UWCubeSat/hs2-gpr-hardware/schematic.pdf

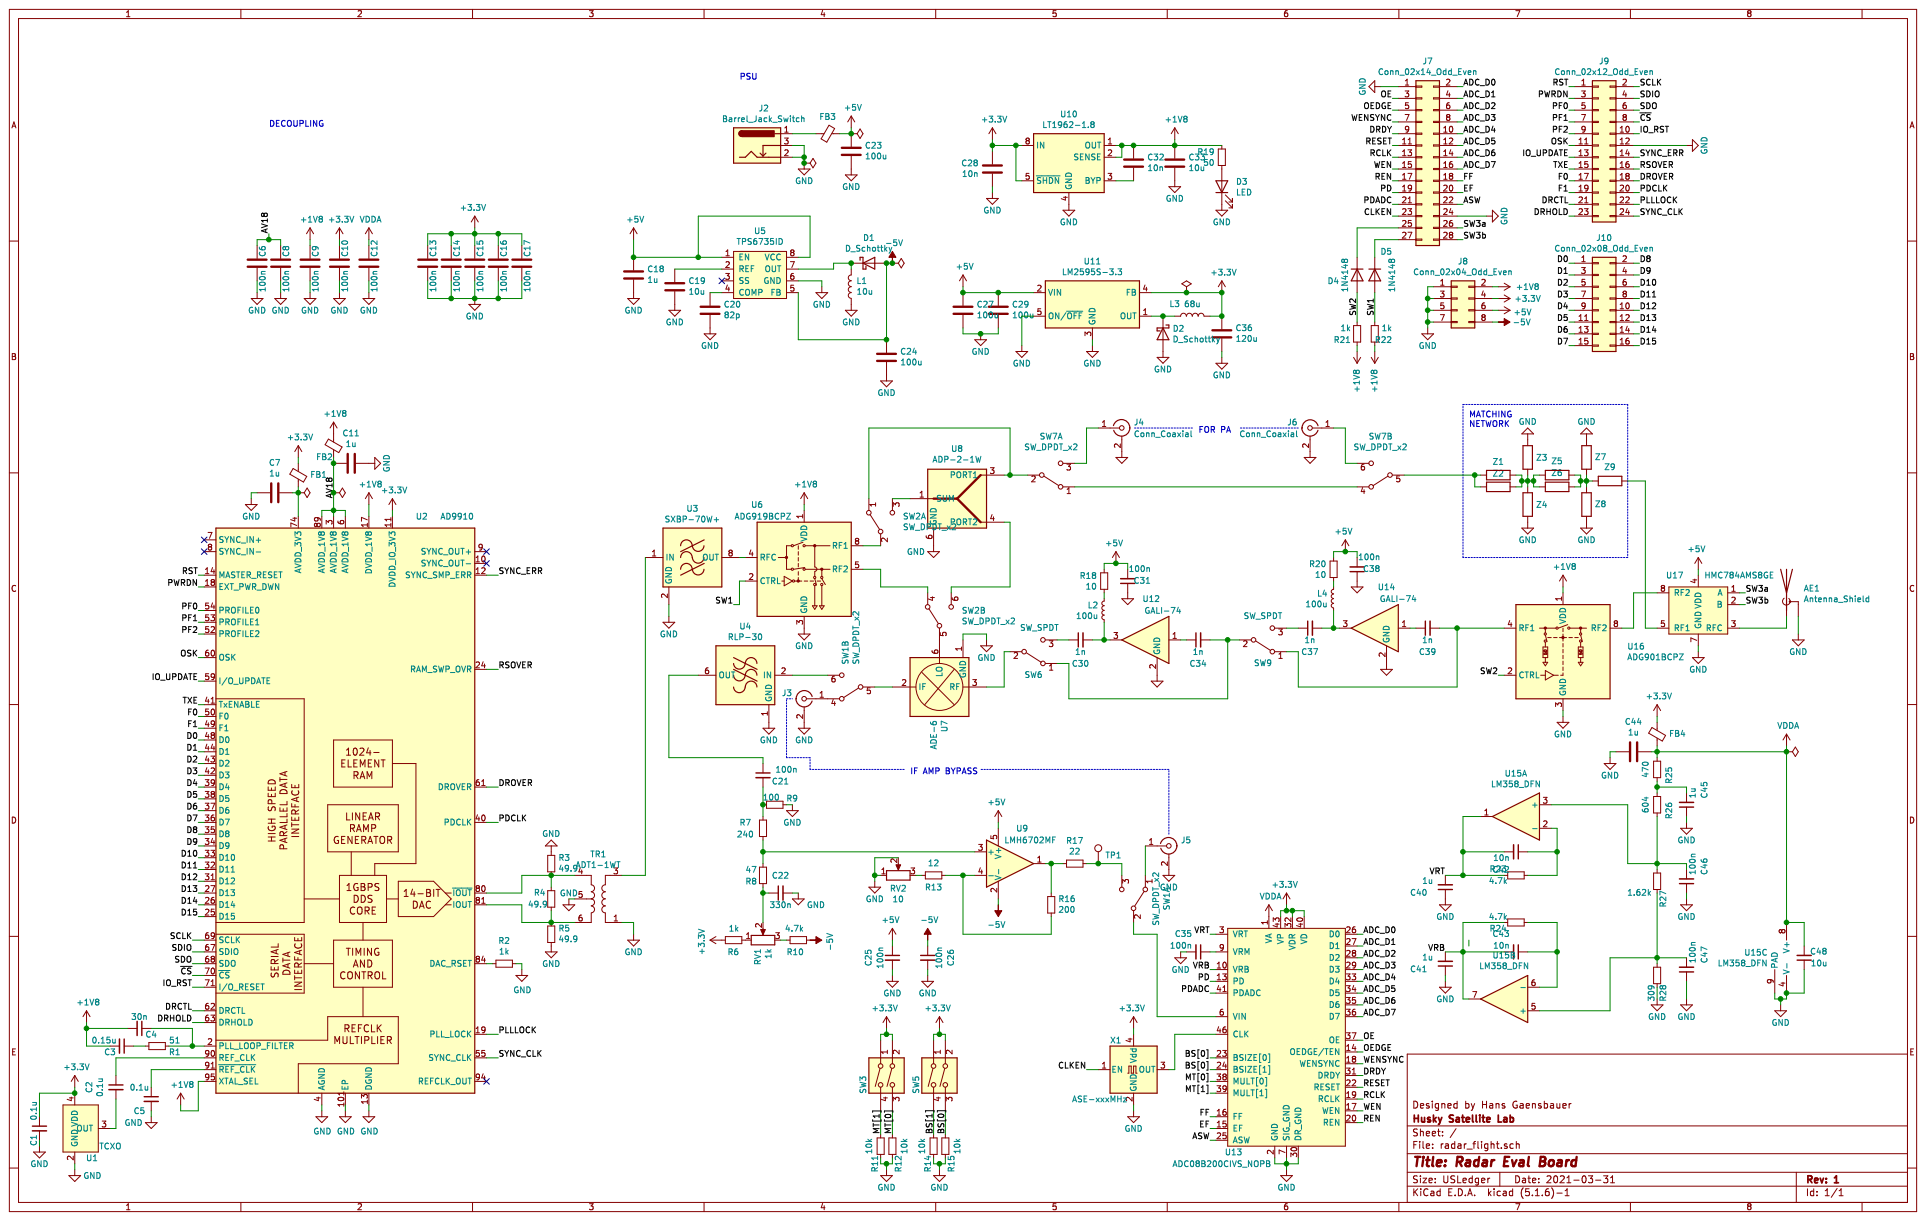
[picture p1: page 1]
