UWCubeSat/hs2-gpr-hardware/radar_flight.kicad_pcb

## KiCad design radar_flight.kicad_pcb (2021-05-08)

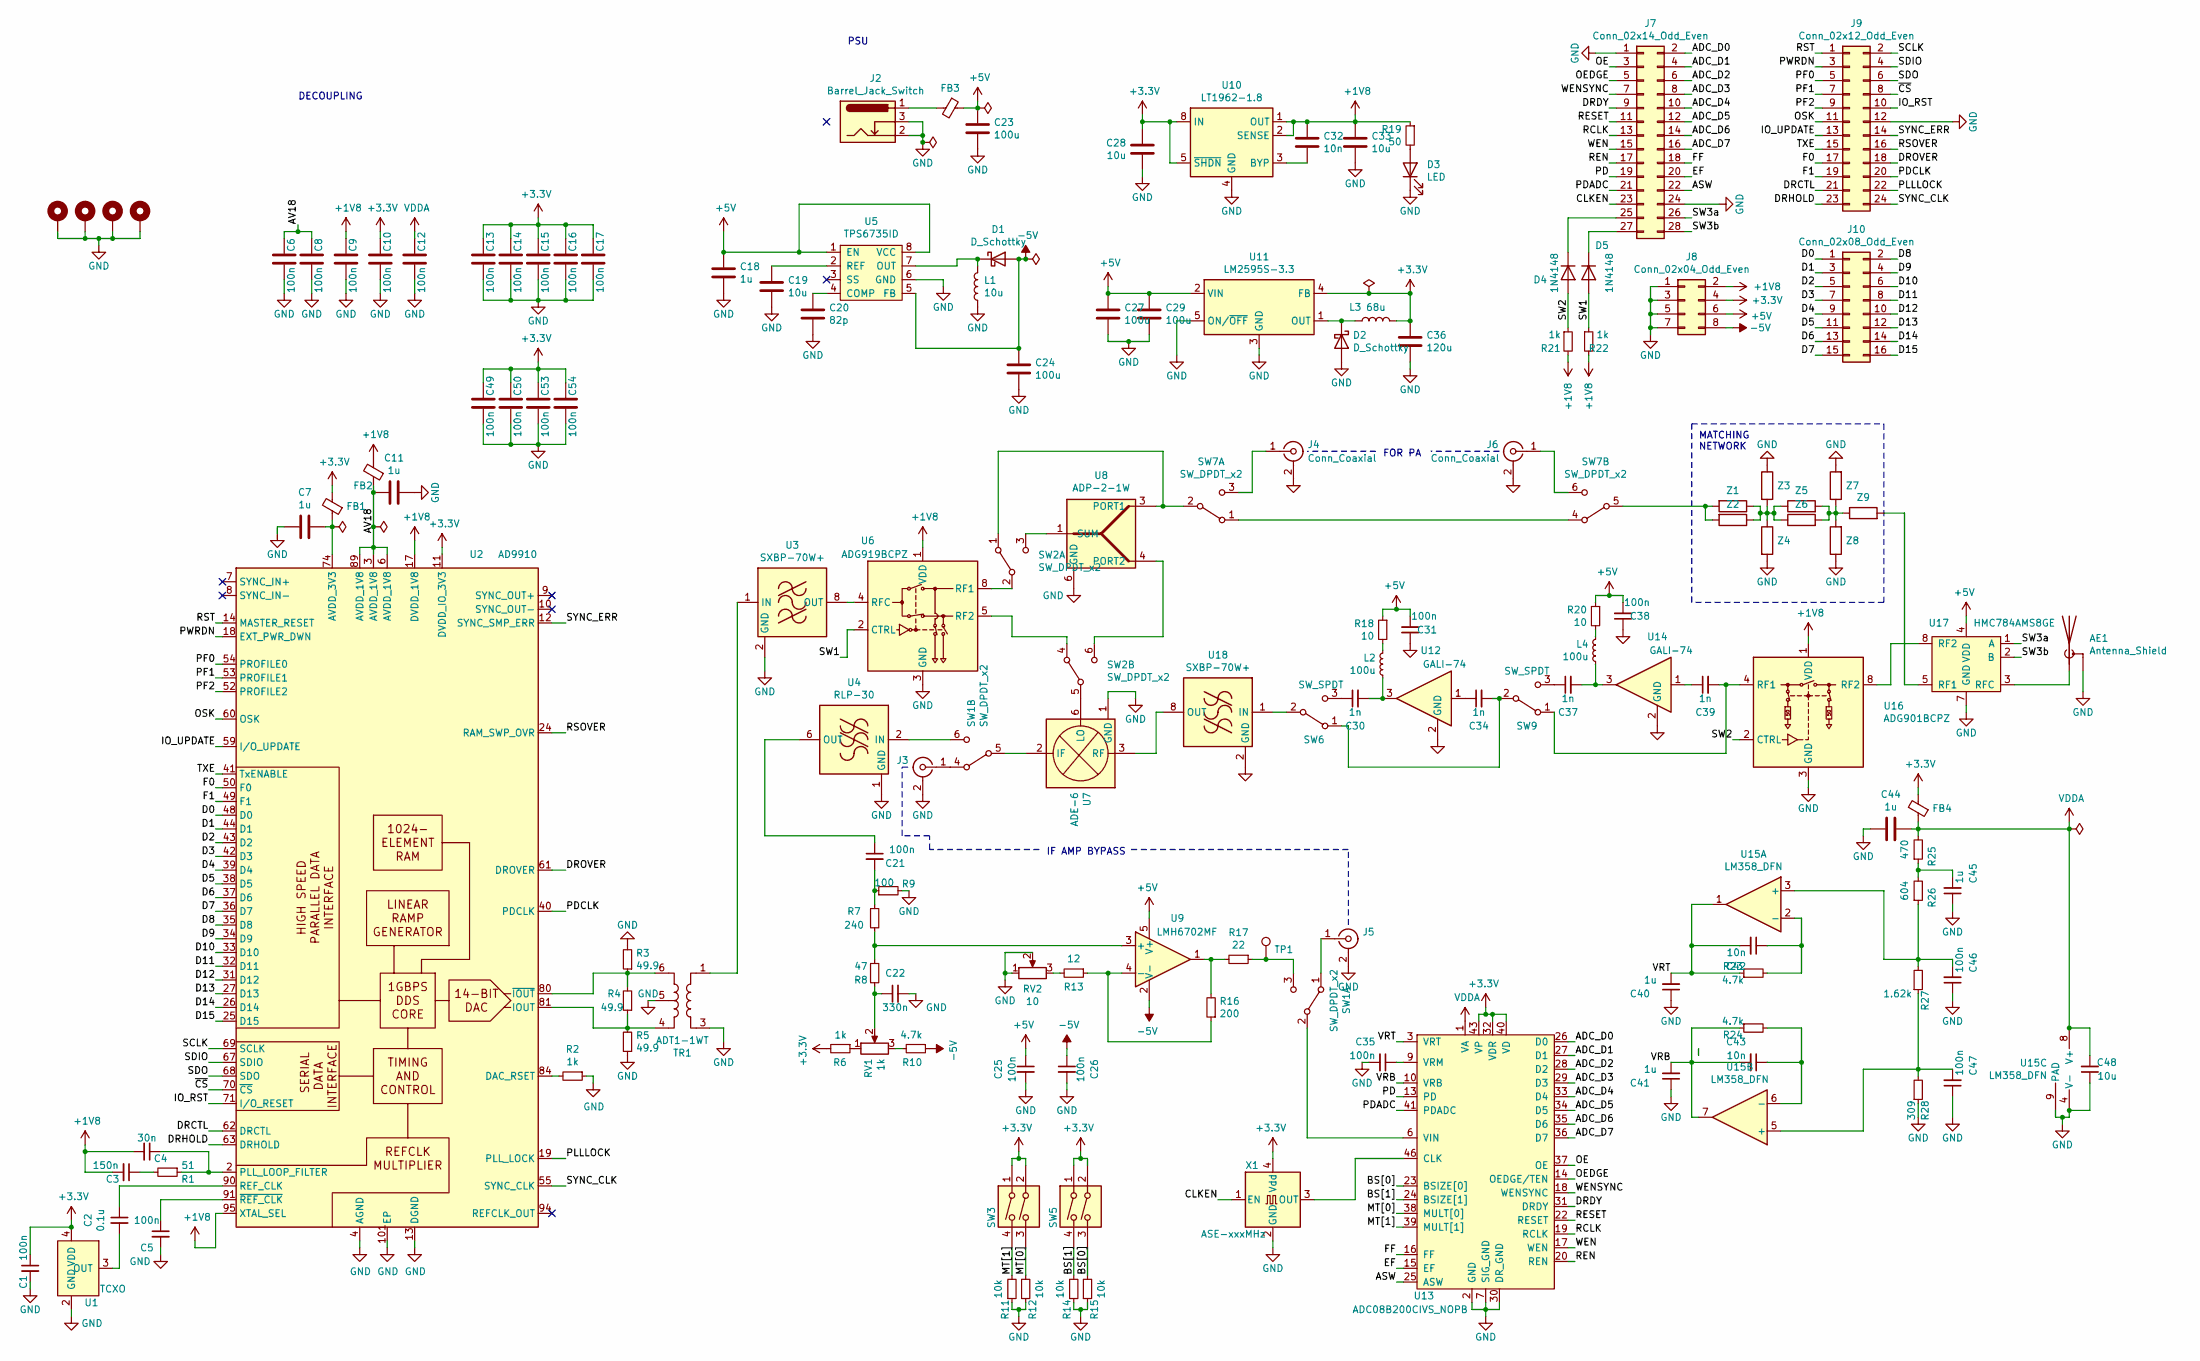
[picture p2: schematic radar_flight.sch, Radar Eval Board]

Parts:
AE1: Antenna_Shield; MMCX_Molex_73415-0961_Horizontal_0.8mm-PCB
C1, C5, C6, C8, C9, C10, C12, C13, C14, C15, C16, C17, C21, C25, C26, C31, C35, C38, C46, C47, C49, C50, C53, C54: 100n; C_0603_1608Metric
C2: 0.1u; C_0603_1608Metric
C3: 150n; C_0603_1608Metric
C4: 30n; C_0603_1608Metric
C7, C11, C18, C40, C41, C44, C45: 1u; C_0603_1608Metric
C19, C28, C33, C48: 10u; C_0603_1608Metric
C20: 82p; C_0603_1608Metric
C22: 330n; C_0603_1608Metric
C23, C24, C27, C29: 100u; C_1206_3216Metric
C30, C34, C37, C39: 1n; C_0603_1608Metric
C32, C42, C43: 10n; C_0603_1608Metric
C36: 120u; C_1206_3216Metric
D1, D2: D_Schottky; D_SMB
D3: LED; LED_0603_1608Metric
D4, D5: 1N4148; D_SOD-123
FB1, FB2, FB3, FB4: Ferrite_Bead_Small; L_0805_2012Metric
H1, H2, H3, H4: MountingHole_Pad; MountingHole_2.2mm_M2_Pad
J2: Barrel_Jack_Switch; BarrelJack_Wuerth_6941xx301002
J3, J4, J5, J6: Conn_Coaxial; SMA_Samtec_SMA-J-P-X-ST-EM1_EdgeMount
J7: Conn_02x14_Odd_Even; PinHeader_2x14_P2.54mm_Horizontal
J8: Conn_02x04_Odd_Even; PinHeader_2x04_P2.54mm_Horizontal
J9: Conn_02x12_Odd_Even; PinHeader_2x12_P2.54mm_Horizontal
J10: Conn_02x08_Odd_Even; PinHeader_2x08_P2.54mm_Horizontal
L1: 10u; L_Bourns-SRU8028_8.0x8.0mm
L2, L4: 100u; L_0805_2012Metric
L3: 68u; L_Bourns-SRU1028_10.0x10.0mm
R1: 51; R_0603_1608Metric
R2, R6, R21, R22: 1k; R_0603_1608Metric
R3, R4, R5: 49.9; R_0603_1608Metric
R7: 240; R_0603_1608Metric
R8: 47; R_0603_1608Metric
R9: 100; R_0603_1608Metric
R10, R23, R24: 4.7k; R_0603_1608Metric
R11, R12, R14, R15: 10k; R_0603_1608Metric
R13: 12; R_0603_1608Metric
R16: 200; R_0603_1608Metric
R17: 22; R_0603_1608Metric
R18, R20: 10; R_0603_1608Metric
R19: 50; R_0603_1608Metric
R25: 470; R_0603_1608Metric
R26: 604; R_0603_1608Metric
R27: 1.62k; R_0603_1608Metric
R28: 309; R_0603_1608Metric
RV1: 1k; Potentiometer_Bourns_3314J_Vertical
RV2: 10; Potentiometer_Bourns_3314J_Vertical
SW1, SW2, SW7: SW_DPDT_x2; SW_DPDT_CK_JS202011JCQN
SW3, SW5: SW_DIP_x02; SW_DIP_SPSTx02_Slide_Omron_A6S-210x_W8.9mm_P2.54mm
SW6, SW9: SW_SPDT; SW_SPDT_CK-JS102011SAQN
TP1: TestPoint; TestPoint_Pad_1.5x1.5mm
TR1: ADT1-1WT; Mini-Circuits_CD542_H2.84mm
U1: TCXO; FOX_5.0x3.2_SMD-4
U2: AD9910; TQFP-100-1EP_14x14mm_P0.5mm_EP5x5mm
U3, U18: SXBP-70W+; Mini-Circuits_HF1139_LandPatternPL-230
U4: RLP-30; Mini-Circuits_GP1212_LandPatternPL-176
U5: TPS6735ID; SOIC-8_3.9x4.9mm_P1.27mm
U6: ADG919BCPZ; LFCSP-8-1EP_3x3mm_P0.5mm_EP1.45x1.74mm
U7: ADE-6; Mini-Circuits_CD542_LandPatternPL-052
U8: ADP-2-1W; Mini-Circuits_CD636_LandPatternPL-035
U9: LMH6702MF; SOT-23-5
U10: LT1962-1.8; MSOP-8_3x3mm_P0.65mm
U11: LM2595S-3.3; TO-263-5_TabPin3
U12, U14: GALI-74; SOT-89-3
U13: ADC08B200CIVS_NOPB; TQFP-48_7x7mm_P0.5mm
U15: LM358_DFN; DFN-8-1EP_2x2mm_P0.5mm_EP1.05x1.75mm
U16: ADG901BCPZ; LFCSP-8-1EP_3x3mm_P0.5mm_EP1.45x1.74mm
U17: HMC784AMS8GE; MSOP-8-1EP_3x3mm_P0.65mm_EP1.95x2.15mm_ThermalVias
X1: ASE-xxxMHz; Oscillator_SMD_Abracon_ASE-4Pin_3.2x2.5mm
Z1, Z2, Z3, Z4, Z5, Z6, Z7, Z8, Z9: R_0805_2012Metric

Connections:
+1V8: C3.2, C4.2, C9.2, C32.2, C33.2, FB2.2, J8.2, R19.1, R21.2, R22.2, U2.17 (DVDD_1V8), U2.23 (DVDD_1V8), U2.30 (DVDD_1V8), U2.47 (DVDD_1V8), U2.57 (DVDD_1V8), U2.64 (DVDD_1V8), U2.95 (XTAL_SEL), U6.1 (VDD), U10.1 (OUT), U10.2 (SENSE), U16.1 (VDD)
+3V3: C1.1, C10.2, C13.2, C14.2, C15.2, C16.2, C17.2, C28.2, C36.2, C49.2, C50.2, C53.2, C54.2, FB1.2, FB4.2, J8.4, L3.2, R6.2, SW3.1, SW3.2, SW5.1, SW5.2, U1.4 (VDD), U2.11 (DVDD_IO_3V3), U2.15 (DVDD_IO_3V3), U2.21 (DVDD_IO_3V3), U2.28 (DVDD_IO_3V3), U2.45 (DVDD_IO_3V3), U2.56 (DVDD_IO_3V3), U2.66 (DVDD_IO_3V3), U10.5 (~SHDN), U10.8 (IN), U11.4 (FB), U13.32 (VDR), U13.40 (VD), U13.43 (VP), U13.44 (VP), U13.48 (VP), X1.4 (Vdd)
+5V: C18.2, C23.2, C25.1, C27.2, C29.2, C31.2, C38.2, FB3.1, J8.6, R18.1, R20.1, U5.1 (EN), U5.8 (VCC), U9.5 (V+), U11.2 (VIN), U17.4 (VDD)
-5V: C24.2, C26.1, D1.2 (A), J8.8, R10.1, U5.5 (FB), U9.2 (V-)
/ADC_D0: J7.2, U13.26 (D0)
/ADC_D1: J7.4, U13.27 (D1)
/ADC_D2: J7.6, U13.28 (D2)
/ADC_D3: J7.8, U13.29 (D3)
/ADC_D4: J7.10, U13.33 (D4)
/ADC_D5: J7.12, U13.34 (D5)
/ADC_D6: J7.14, U13.35 (D6)
/ADC_D7: J7.16, U13.36 (D7)
/ASW: J7.22, U13.25 (ASW)
/AV18: C6.2, C8.2, C11.1, FB2.1, U2.3 (AVDD_1V8), U2.6 (AVDD_1V8), U2.89 (AVDD_1V8), U2.92 (AVDD_1V8)
/BS[0]: R15.2, SW5.3, U13.23 (BSIZE[0])
/BS[1]: R14.2, SW5.4, U13.24 (BSIZE[1])
/CLKEN: J7.23, X1.1 (EN)
/D0: J10.1, U2.48 (D0)
/D1: J10.3, U2.44 (D1)
/D2: J10.5, U2.43 (D2)
/D3: J10.7, U2.42 (D3)
/D4: J10.9, U2.39 (D4)
/D5: J10.11, U2.38 (D5)
/D6: J10.13, U2.37 (D6)
/D7: J10.15, U2.36 (D7)
/D8: J10.2, U2.35 (D8)
/D9: J10.4, U2.34 (D9)
/D10: J10.6, U2.33 (D10)
/D11: J10.8, U2.32 (D11)
/D12: J10.10, U2.31 (D12)
/D13: J10.12, U2.27 (D13)
/D14: J10.14, U2.26 (D14)
/D15: J10.16, U2.25 (D15)
/DRCTL: J9.21, U2.62 (DRCTL)
/DRDY: J7.9, U13.31 (DRDY)
/DRHOLD: J9.23, U2.63 (DRHOLD)
/DROVER: J9.18, U2.61 (DROVER)
/EF: J7.20, U13.15 (EF)
/F0: J9.17, U2.50 (F0)
/F1: J9.19, U2.49 (F1)
/FF: J7.18, U13.16 (FF)
/IO_RST: J9.10, U2.71 (I/O_RESET)
/IO_UPDATE: J9.13, U2.59 (I/O_UPDATE)
/MT[0]: R12.2, SW3.3, U13.38 (MULT[0])
/MT[1]: R11.2, SW3.4, U13.39 (MULT[1])
/OE: J7.3, U13.37 (OE)
/OEDGE: J7.5, U13.14 (OEDGE/TEN)
/OSK: J9.11, U2.60 (OSK)
/PD: J7.19, U13.13 (PD)
/PDADC: J7.21, U13.41 (PDADC)
/PDCLK: J9.20, U2.40 (PDCLK)
/PF0: J9.5, U2.54 (PROFILE0)
/PF1: J9.7, U2.53 (PROFILE1)
/PF2: J9.9, U2.52 (PROFILE2)
/PLLLOCK: J9.22, U2.19 (PLL_LOCK)
/PWRDN: J9.3, U2.18 (EXT_PWR_DWN)
/RCLK: J7.13, U13.19 (RCLK)
/REN: J7.17, U13.20 (REN)
/RESET: J7.11, U13.22 (RESET)
/RSOVER: J9.16, U2.24 (RAM_SWP_OVR)
/RST: J9.1, U2.14 (MASTER_RESET)
/SCLK: J9.2, U2.69 (SCLK)
/SDIO: J9.4, U2.67 (SDIO)
/SDO: J9.6, U2.68 (SDO)
/SW1: D5.2 (A), R22.1, U6.2 (CTRL)
/SW2: D4.2 (A), R21.1, U16.2 (CTRL)
/SW3a: J7.26, U17.1 (A)
/SW3b: J7.28, U17.2 (B)
/SYNC_CLK: J9.24, U2.55 (SYNC_CLK)
/SYNC_ERR: J9.14, U2.12 (SYNC_SMP_ERR)
/TXE: J9.15, U2.41 (TxENABLE)
/VRB: C41.2, C43.2, R24.1, U13.10 (VRB), U15.7
/VRT: C40.2, C42.2, R23.1, U13.3 (VRT), U15.1
/WEN: J7.15, U13.17 (WEN)
/WENSYNC: J7.7, U13.18 (WENSYNC)
/~CS: J9.8, U2.70 (~CS)
GND: AE1.2 (Shield), C1.2, C5.2, C6.1, C7.1, C8.1, C9.1, C10.1, C11.2, C12.1, C13.1, C14.1, C15.1, C16.1, C17.1, C18.1, C19.1, C20.1, C22.2, C23.1, C24.1, C25.2, C26.2, C27.1, C28.1, C29.1, C31.1, C33.1, C35.2, C36.1, C38.1, C40.1, C41.1, C44.1, C45.1, C46.1, C47.1, C48.1, C49.1, C50.1, C53.1, C54.1, D2.2 (A), D3.1 (K), H1.1, H2.1, H3.1, H4.1, J2.2, J2.3, J3.2 (Ext), J4.2 (Ext), J5.2 (Ext), J6.2 (Ext), J7.1, J7.24, J8.1, J8.3, J8.5, J8.7, J9.12, L1.1, R2.1, R3.2, R5.1, R9.2, R11.1, R12.1, R14.1, R15.1, R28.1, RV2.1, RV2.2, TR1.3, TR1.5, U1.2 (GND), U2.4 (AGND), U2.5 (AGND), U2.13 (DGND), U2.16 (DGND), U2.22 (DGND), U2.29 (DGND), U2.46 (DGND), U2.51 (DGND), U2.58 (DGND), U2.65 (DGND), U2.73 (AGND), U2.78 (AGND), U2.79 (AGND), U2.82 (AGND), U2.85 (AGND), U2.88 (AGND), U2.96 (AGND), U2.101 (EP), U3.2 (GND), U3.3 (GND), U3.4 (GND), U3.5 (GND), U3.6 (GND), U3.7 (GND), U4.1 (GND), U4.3 (GND), U4.4 (GND), U4.5 (GND), U4.7 (GND), U4.8 (GND), U5.6 (GND), U6.3 (GND), U6.6 (GND), U6.7 (GND), U6.9 (GND), U7.1 (GND), U7.4 (GND), U7.5 (GND), U8.6 (GND), U10.4 (GND), U11.3 (GND), U11.5 (ON/~OFF), U12.2 (GND), U13.2 (GND), U13.5 (GND), U13.7 (SIG_GND), U13.8 (GND), U13.11 (GND), U13.21 (GND), U13.30 (DR_GND), U13.42 (GND), U13.45 (GND), U13.47 (GND), U14.2 (GND), U15.4 (V-), U15.9 (PAD), U16.3 (GND), U16.5 (GND), U16.6 (GND), U16.7 (GND), U16.9 (GND), U17.6 (GND), U17.7 (GND), U17.9 (GND), U18.2 (GND), U18.3 (GND), U18.4 (GND), U18.5 (GND), U18.6 (GND), U18.7 (GND), X1.2 (GND), Z3.1, Z4.2, Z7.2, Z8.1
unnamed: AE1.1 (A), U17.3 (RFC)
unnamed: C2.1, U2.90 (REF_CLK)
unnamed: C2.2, U1.3 (OUT)
unnamed: C3.1, R1.2
unnamed: C4.1, R1.1, U2.2 (PLL_LOOP_FILTER)
unnamed: C5.1, U2.91 (~REF_CLK)
unnamed: C7.2, FB1.1, U2.74 (AVDD_3V3), U2.75 (AVDD_3V3), U2.76 (AVDD_3V3), U2.77 (AVDD_3V3), U2.83 (AVDD_3V3)
unnamed: C19.2, U5.2 (REF)
unnamed: C20.2, U5.4 (COMP)
unnamed: C21.1, U4.6 (OUT)
unnamed: C21.2, R7.1, R9.1
unnamed: C22.1, R8.2, RV1.2
unnamed: C30.1, SW6.3 (C)
unnamed: C30.2, L2.2, U12.3
unnamed: C32.1, U10.3 (BYP)
unnamed: C34.1, U12.1
unnamed: C34.2, SW6.1 (A), SW9.2 (B)
unnamed: C35.1, U13.9 (VRM)
unnamed: C37.1, SW9.3 (C)
unnamed: C37.2, L4.2, U14.3
unnamed: C39.1, U14.1
unnamed: C39.2, SW9.1 (A), U16.4 (RF1)
unnamed: C42.1, R23.2, U15.2 (-)
unnamed: C43.1, R24.2, U15.6 (-)
unnamed: C45.2, R25.1, R26.2
unnamed: C46.2, R26.1, R27.2, U15.3 (+)
unnamed: C47.2, R27.1, R28.2, U15.5 (+)
unnamed: D1.1 (K), L1.2, U5.7 (OUT)
unnamed: D2.1 (K), L3.1, U11.1 (OUT)
unnamed: D3.2 (A), R19.2
unnamed: D4.1 (K), J7.25
unnamed: D5.1 (K), J7.27
unnamed: FB3.2, J2.1
unnamed: J3.1 (In), SW1.4 (A)
unnamed: J4.1 (In), SW7.3 (C)
unnamed: J5.1 (In), SW1.1 (A)
unnamed: J6.1 (In), SW7.6 (C)
unnamed: L2.1, R18.2
unnamed: L4.1, R20.2
unnamed: R2.2, U2.84 (DAC_RSET)
unnamed: R3.1, R4.2, TR1.6, U2.80 (~IOUT)
unnamed: R4.1, R5.2, TR1.4, U2.81 (IOUT)
unnamed: R6.1, RV1.1
unnamed: R7.2, R8.1, U9.3 (+)
unnamed: R10.2, RV1.3
unnamed: R13.1, R16.1, U9.4 (-)
unnamed: R13.2, RV2.3
unnamed: R16.2, R17.2, U9.1
unnamed: R17.1, SW1.3 (C), TP1.1
unnamed: SW1.2 (B), U13.6 (VIN)
unnamed: SW1.5 (B), U7.2 (IF)
unnamed: SW1.6 (C), U4.2 (IN)
unnamed: SW2.1 (A), SW7.2 (B), U8.3 (PORT1)
unnamed: SW2.2 (B), U6.8 (RF1)
unnamed: SW2.3 (C), U8.1 (SUM)
unnamed: SW2.4 (A), U6.5 (RF2)
unnamed: SW2.5 (B), U7.6 (LO)
unnamed: SW2.6 (C), U8.4 (PORT2)
unnamed: SW6.2 (B), U18.1 (IN)
unnamed: SW7.1 (A), SW7.4 (A)
unnamed: SW7.5 (B), Z1.2, Z2.2
unnamed: TR1.1, U3.1 (IN)
unnamed: U3.8 (OUT), U6.4 (RFC)
unnamed: U13.46 (CLK), X1.3 (OUT)
unnamed: U16.8 (RF2), U17.8 (RF2)
unnamed: U17.5 (RF1), Z9.2
unnamed: U7.3 (RF), U18.8 (OUT)
unnamed: Z1.1, Z2.1, Z3.2, Z4.1, Z5.1, Z6.1
unnamed: Z5.2, Z6.2, Z7.1, Z8.2, Z9.1
VA: C12.2, C44.2, C48.2, FB4.1, R25.2, U13.1 (VA), U13.4 (VA), U13.12 (VA), U15.8 (V+)

Notes on the sheet:
MATCHING NETWORK
FOR PA
PSU
IF AMP BYPASS
DECOUPLING

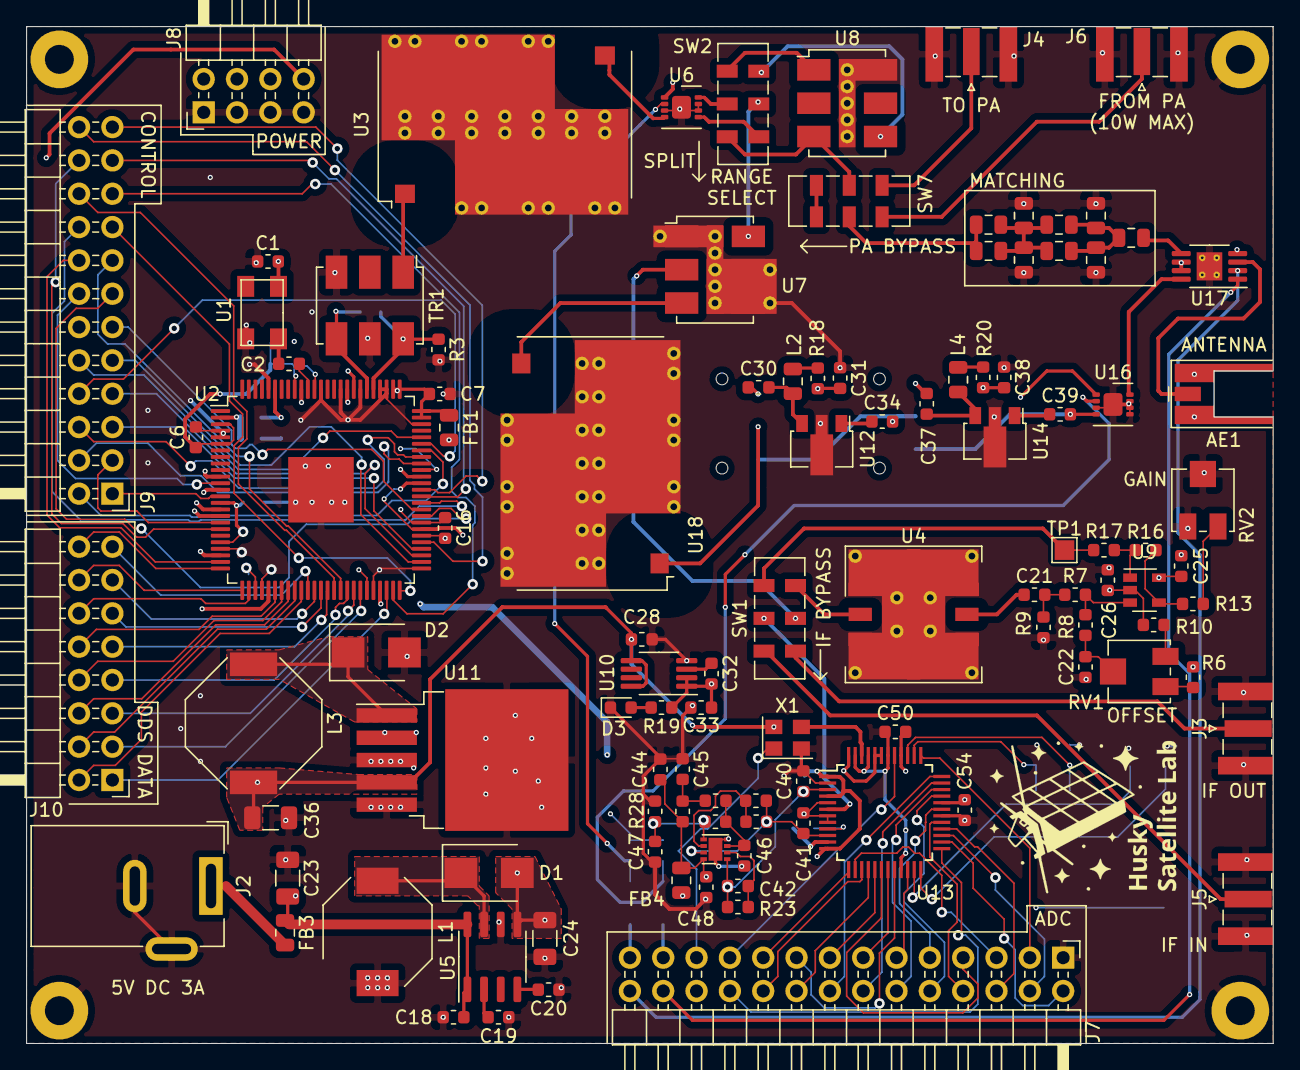
[picture p3: board radar_flight.kicad_pcb from above]

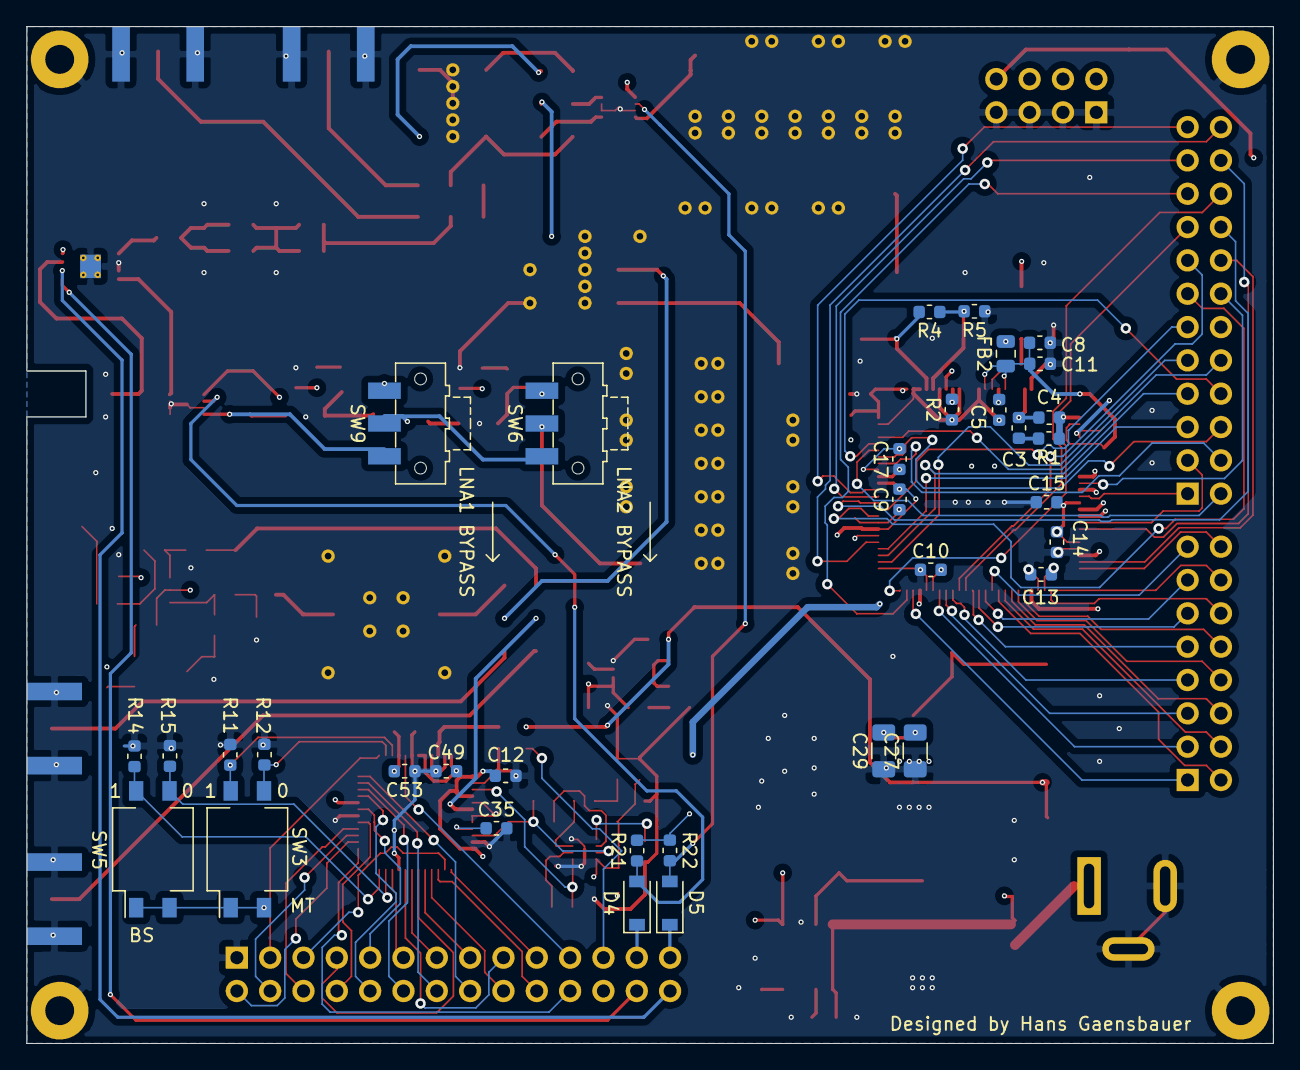
[picture p4: board radar_flight.kicad_pcb from below]

Board: 4 copper layers, 95.0 x 77.5 mm, 146 parts (34 on the bottom side), 147 nets.
